monotech/NuXTv2/Project NuXT.sch

## KiCad design Project NuXT.sch (2020-03-05)

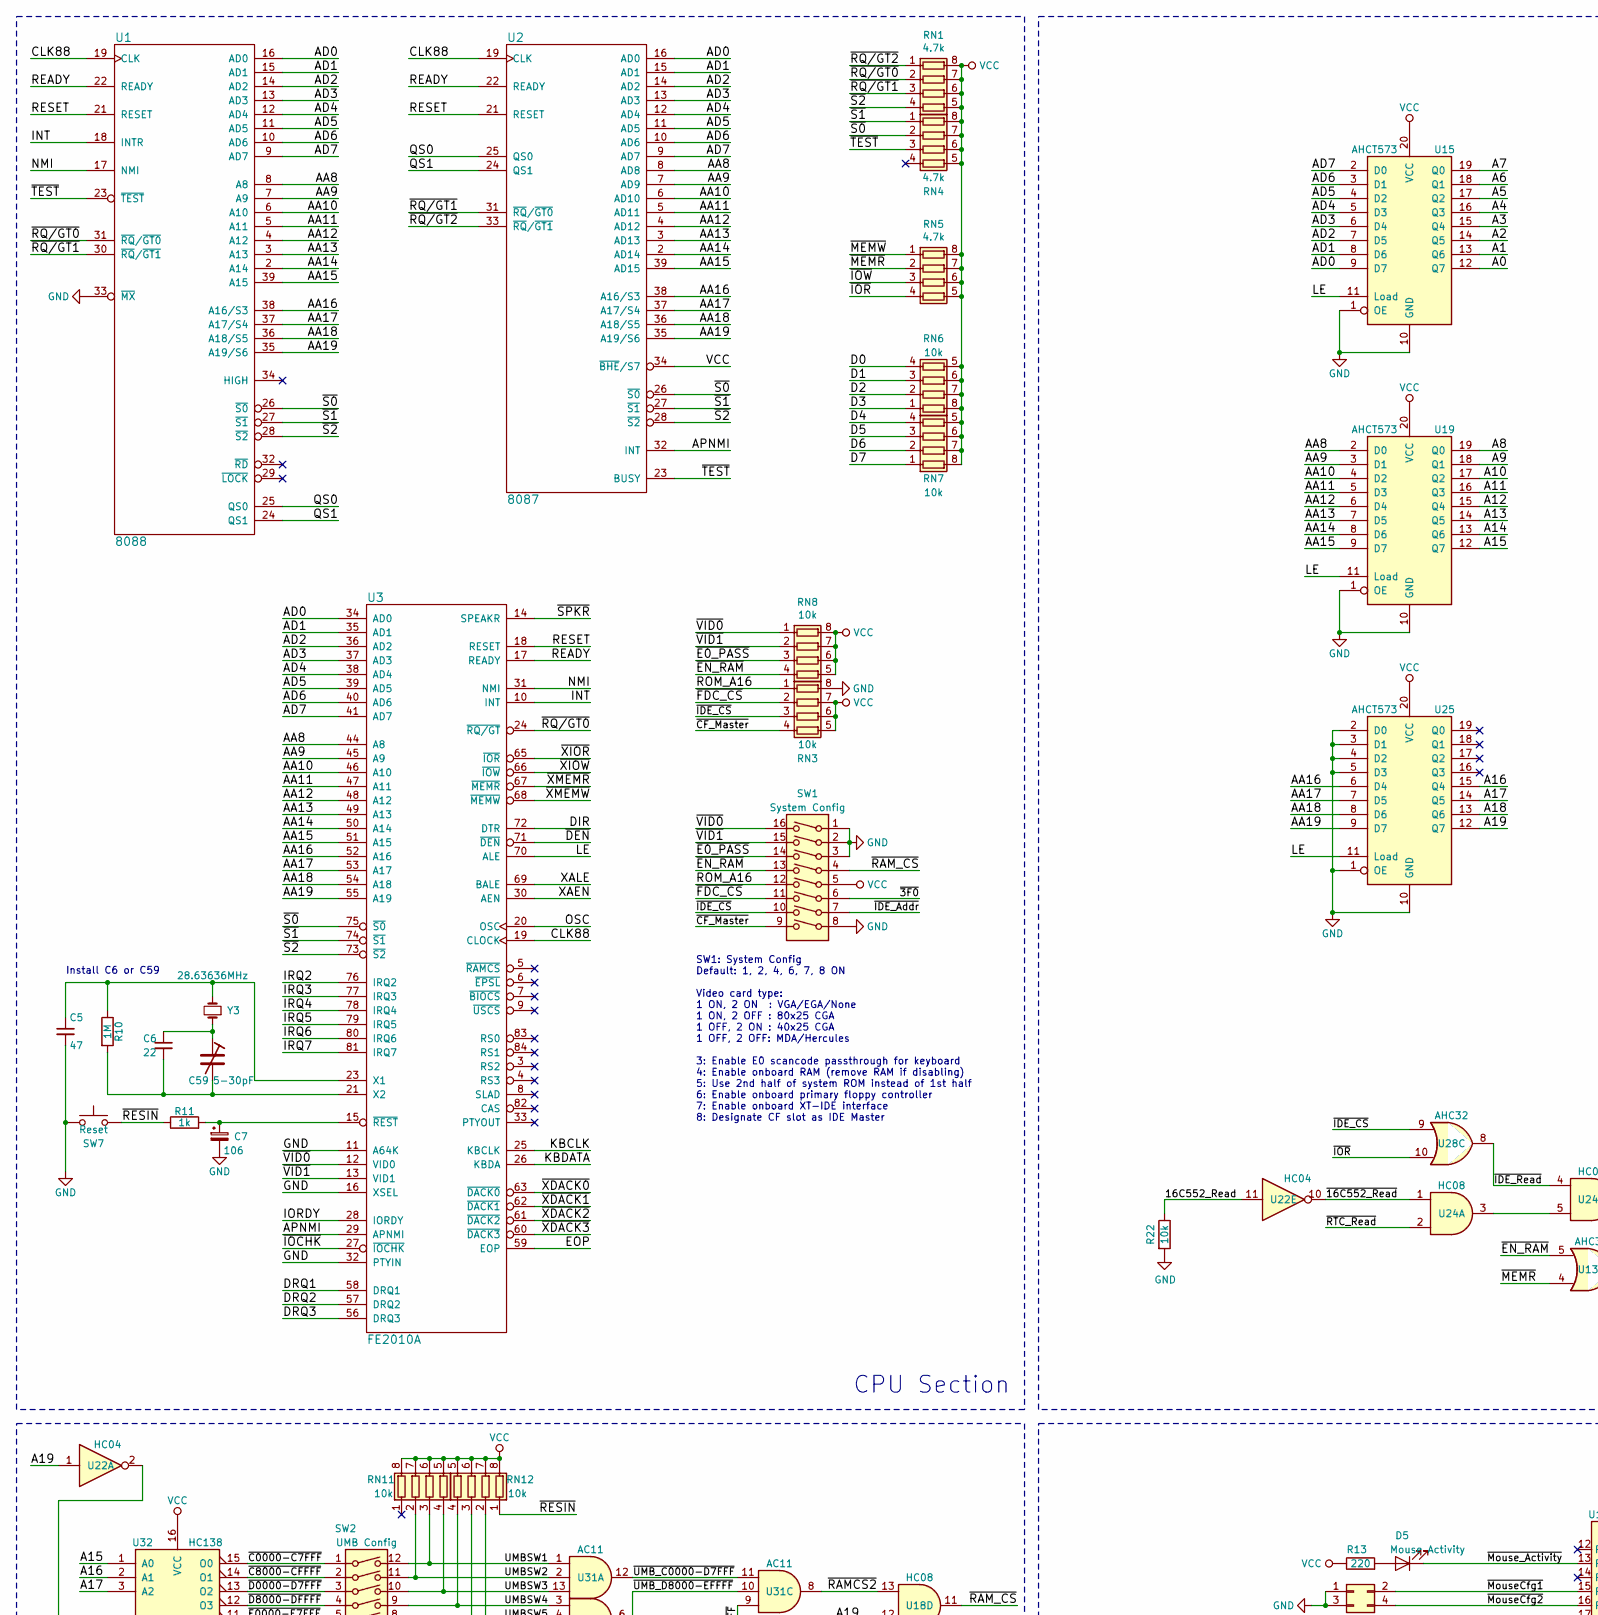
[picture p6: schematic Project NuXT.sch, part in row 1, column 1]

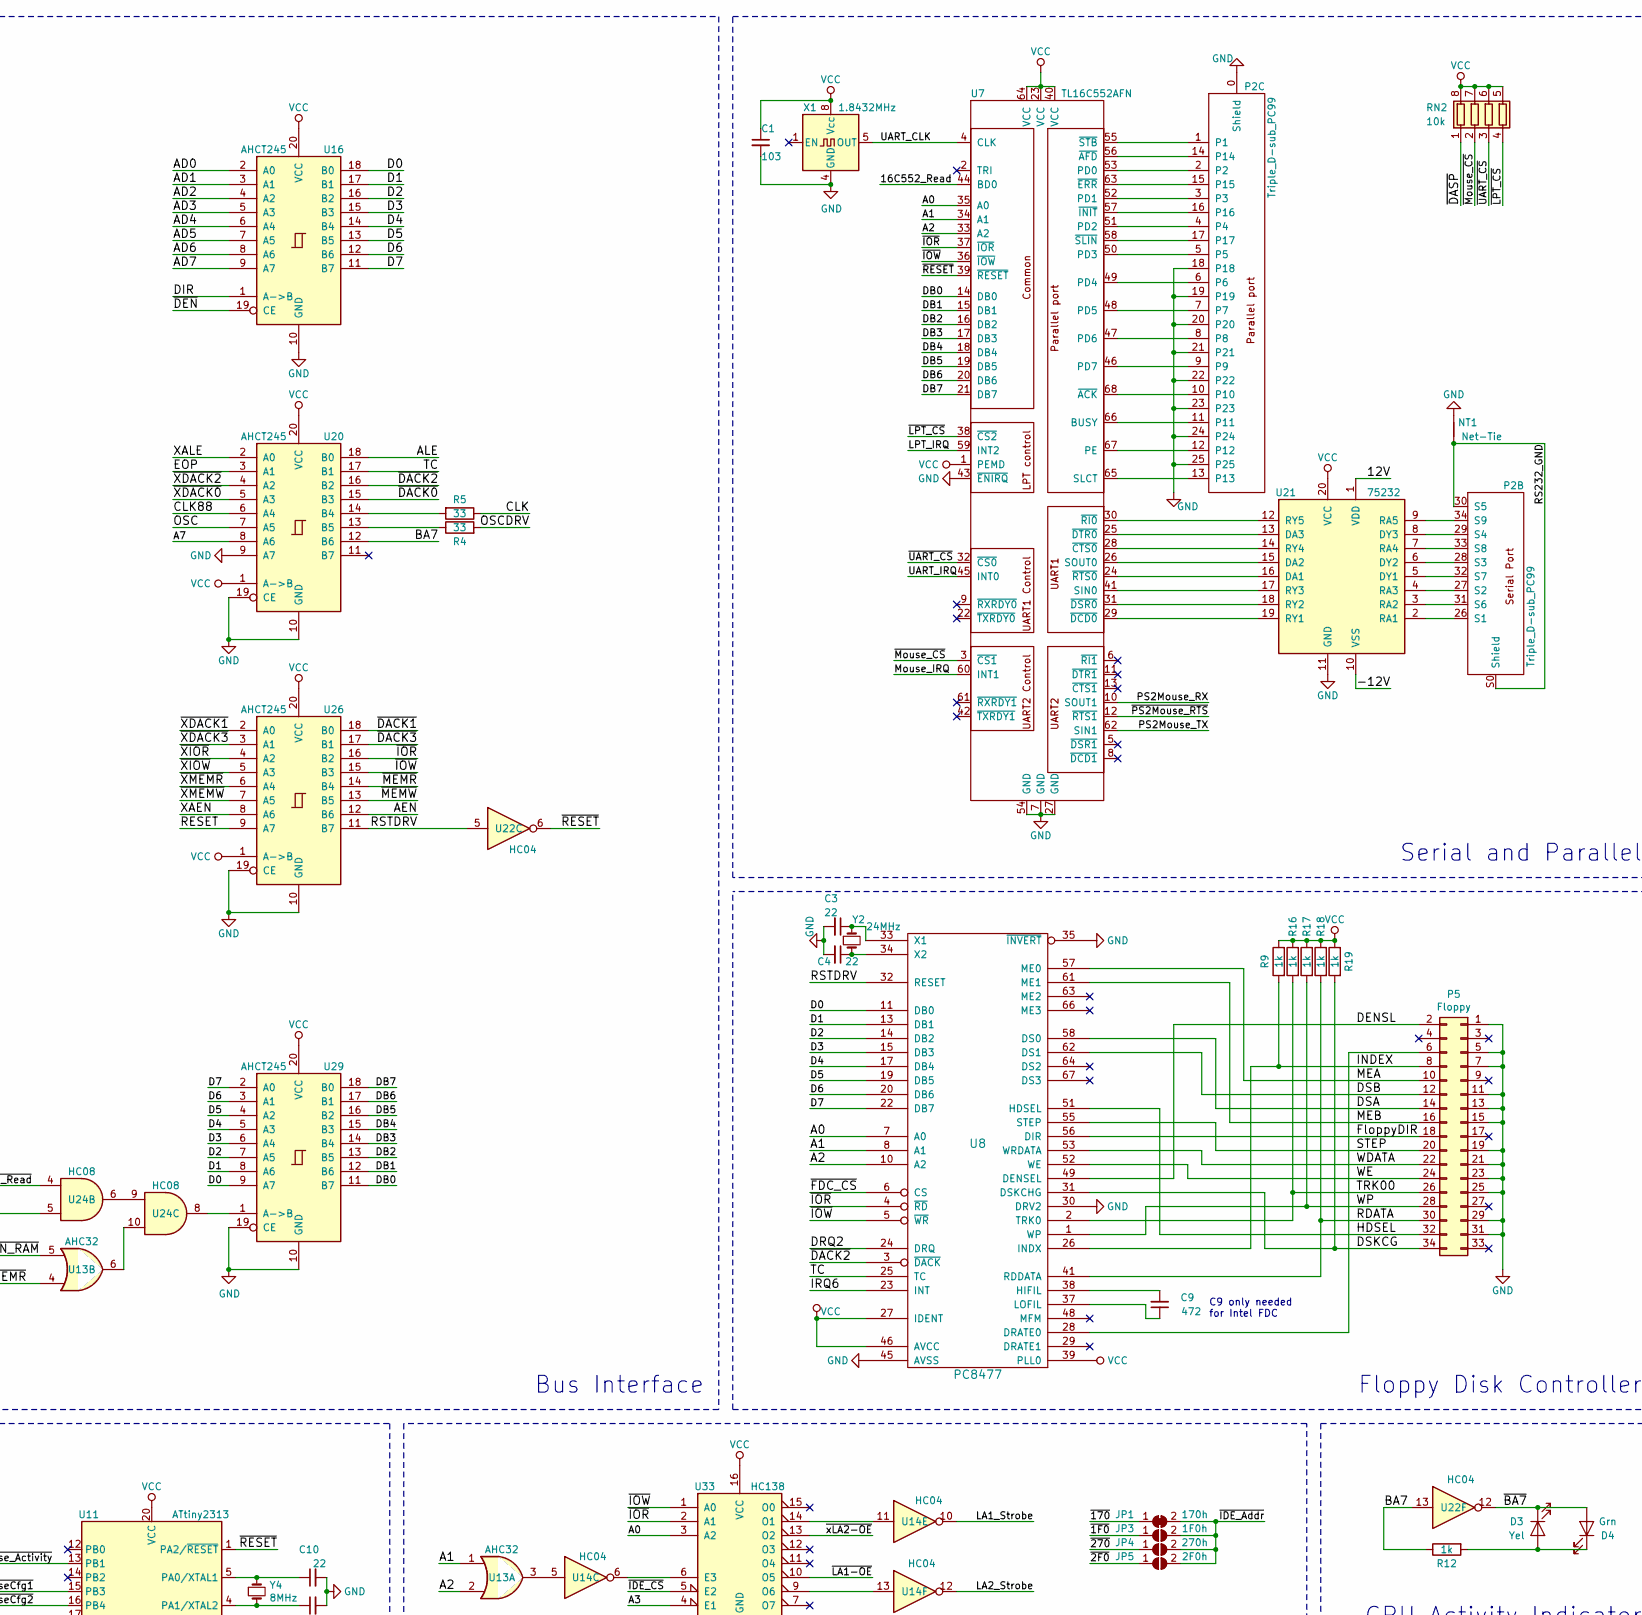
[picture p7: schematic Project NuXT.sch, part in row 1, column 2]

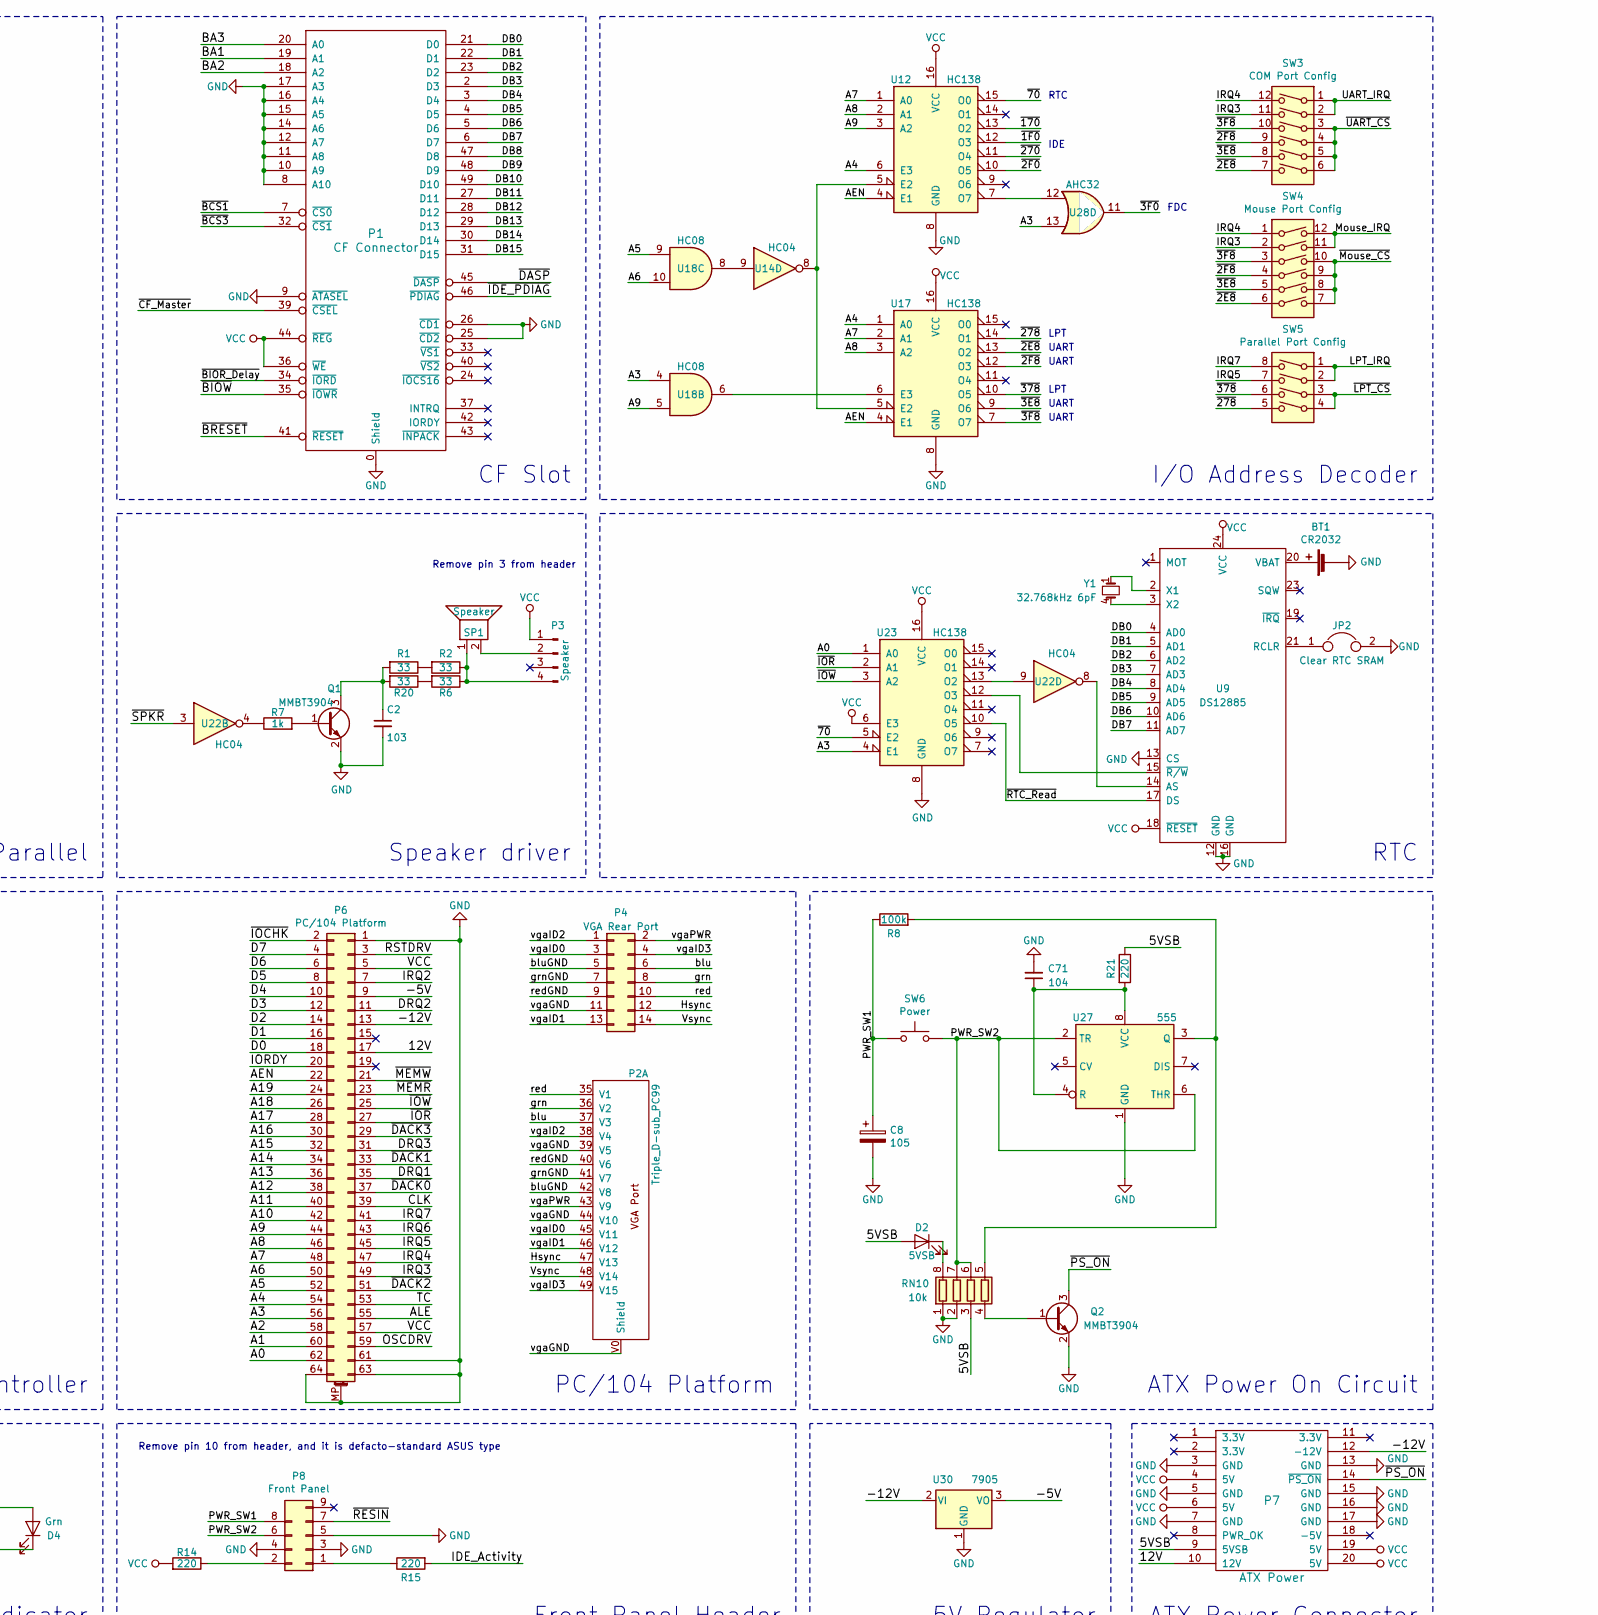
[picture p8: schematic Project NuXT.sch, part in row 1, column 3]

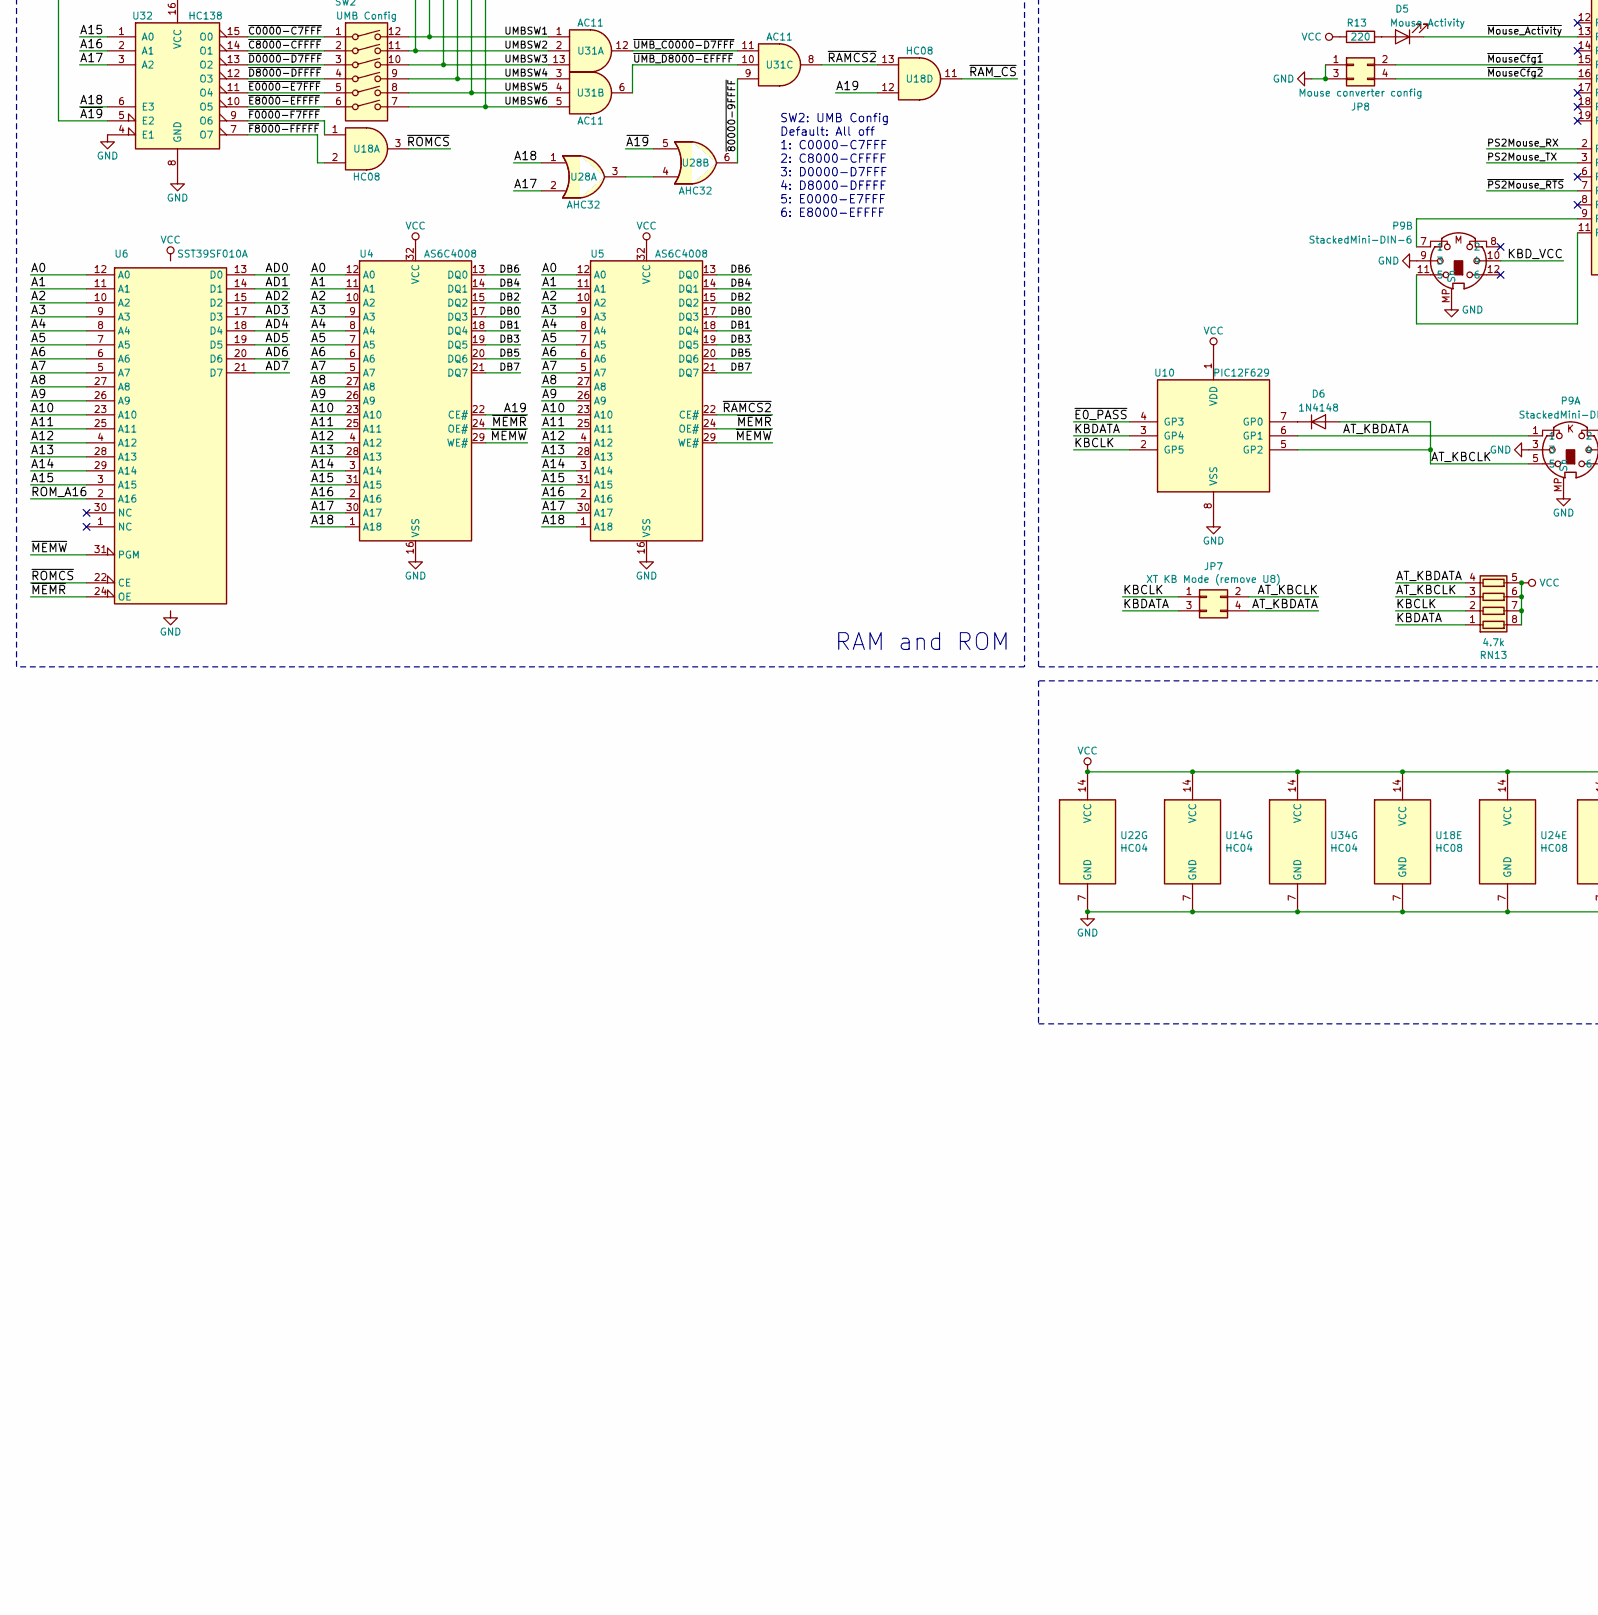
[picture p9: schematic Project NuXT.sch, part in row 2, column 1]

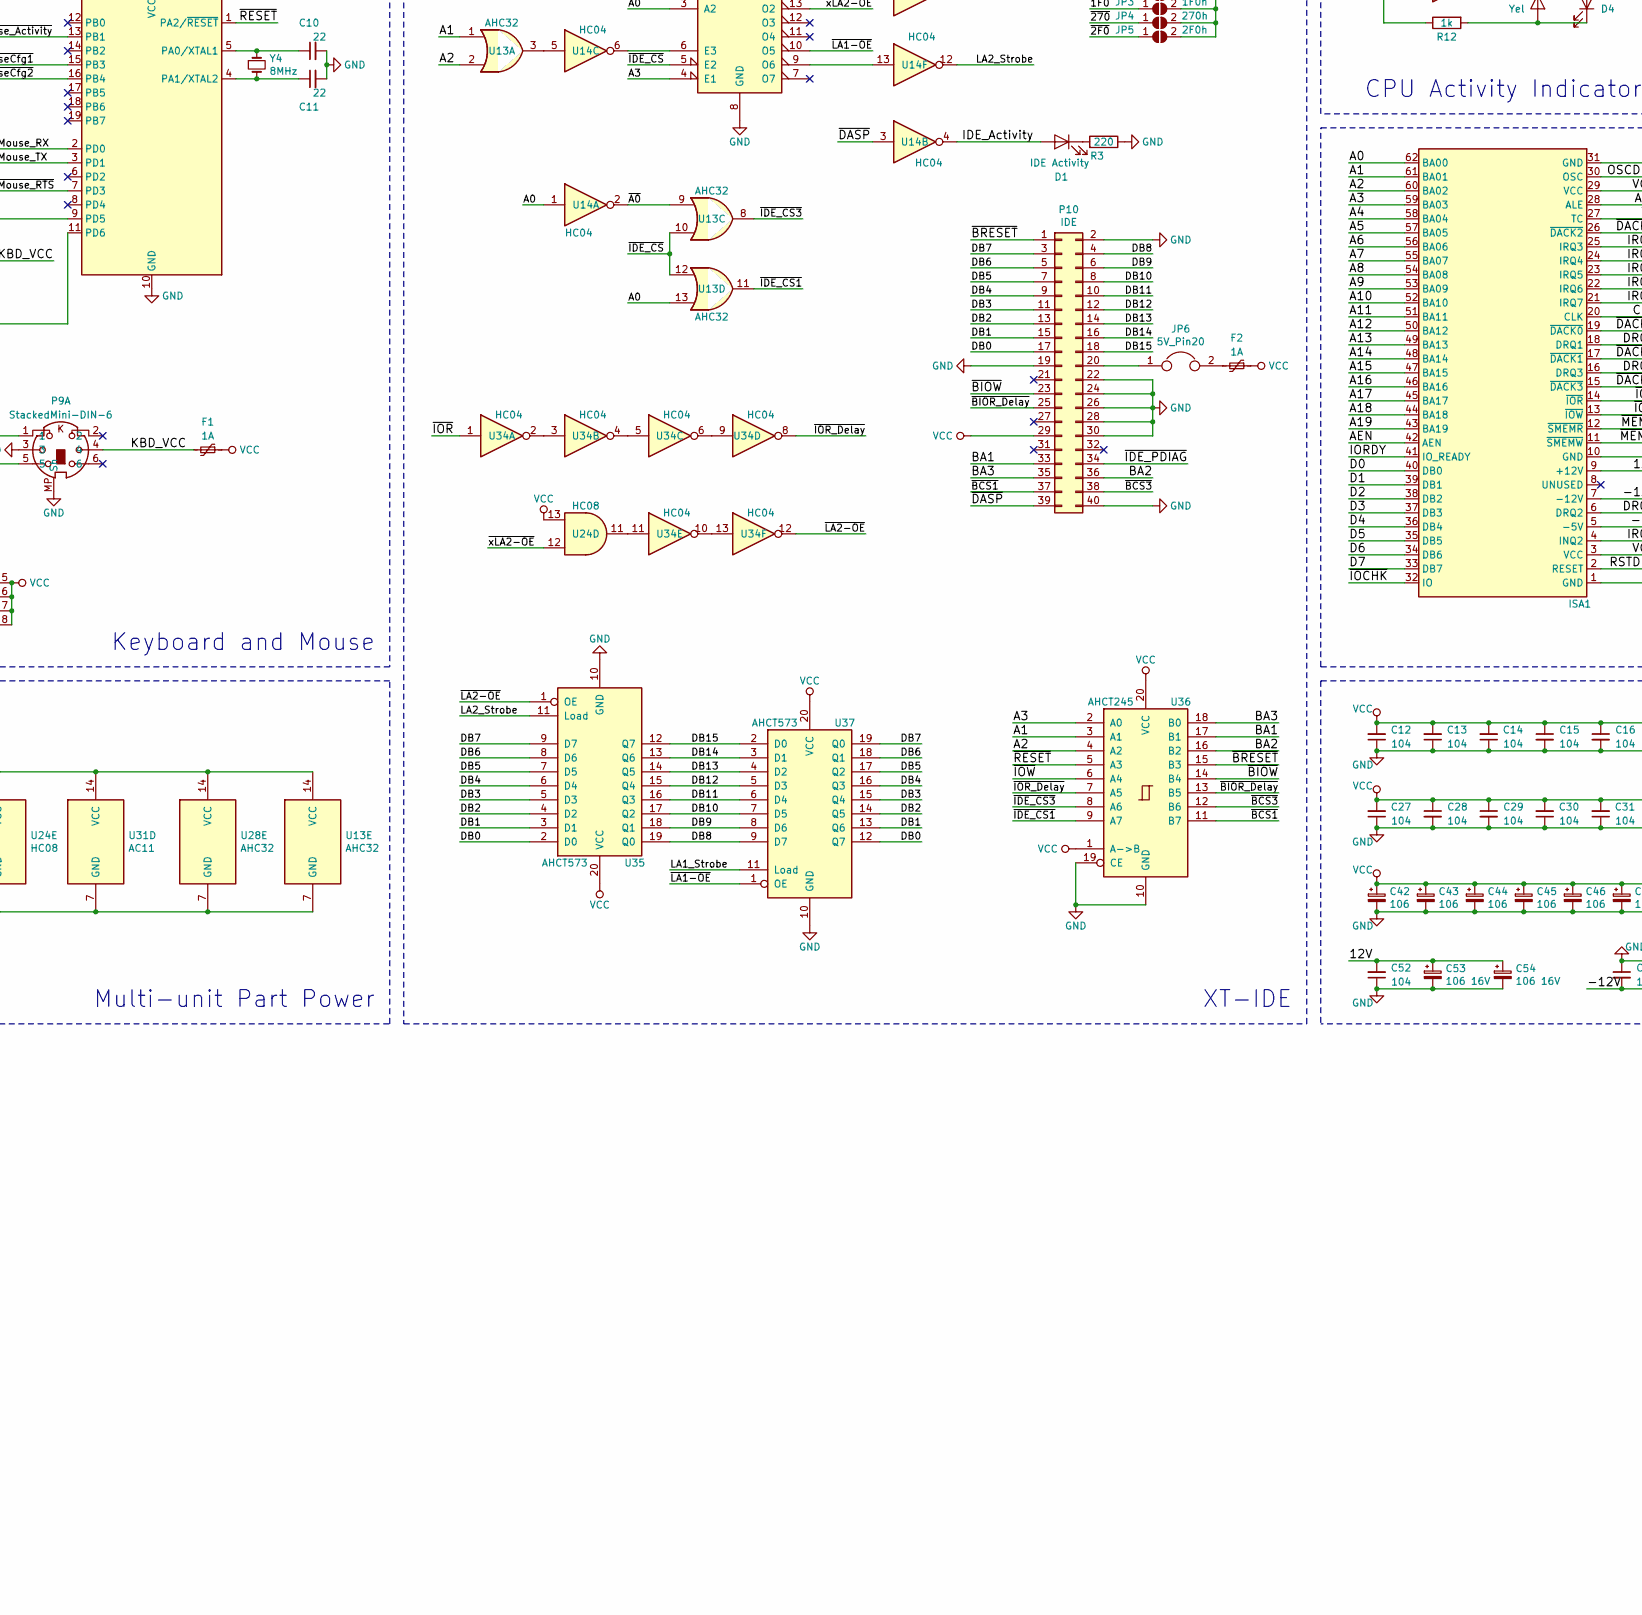
[picture p10: schematic Project NuXT.sch, part in row 2, column 2]

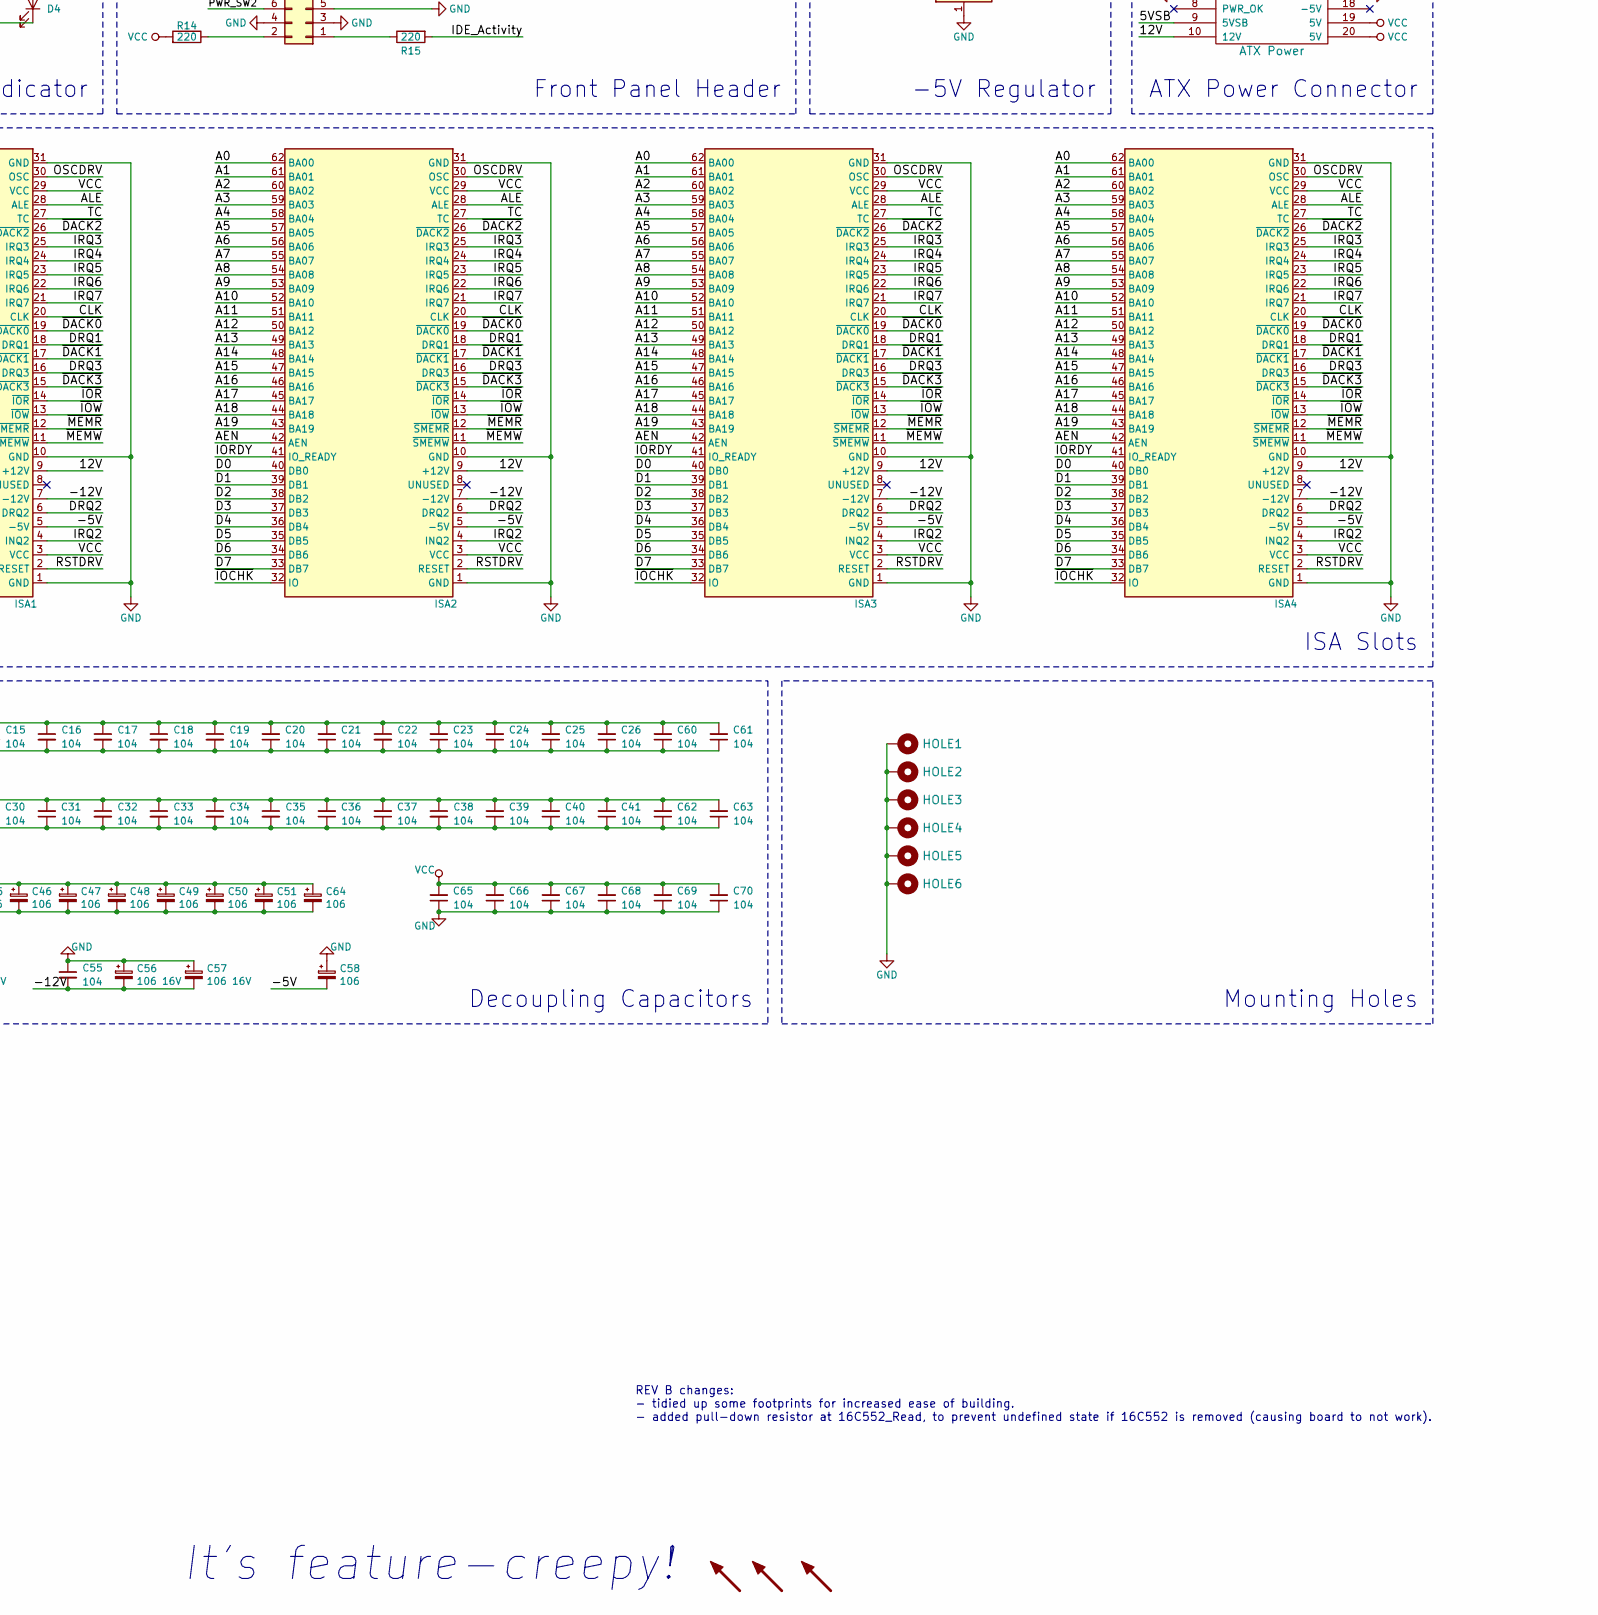
[picture p11: schematic Project NuXT.sch, part in row 2, column 3]

Parts:
BT1: CR2032; CR2032 THT Holder
C1, C2: 103; C_0805_2012Metric
C3, C4, C6, C10, C11: 22; C_0805_2012Metric
C5: 47; C_0805_2012Metric
C7, C42, C43, C44, C45, C46, C47, C48, C49, C50, C51, C58, C64: 106; C_0603_1608Metric
C8: 105; C_0805_2012Metric
C9: 472; C_0805_2012Metric
C12, C13, C14, C15, C16, C17, C18, C19, C20, C21, C22, C23, C24, C25, C26, C27, C28, C29, C30, C31, C32, C33, C34, C35, C36, C37, C38, C39, C40, C41, C52, C55, C60, C61, C62, C63, C65, C66, C67, C68, C69, C70, C71: 104; C_0603_1608Metric
C53, C54, C56, C57: 106 16V; C_0805_2012Metric
C59: 5-30pF; C_Trim_Murata
D1: IDE Activity; 3mm_LED_RightAngle
D2: 5VSB; LED_0805_2012Metric
D3: Yel; LED_0603_1608Metric
D4: Grn; LED_0603_1608Metric
D5: Mouse Activity; 3mm_LED_RightAngle
D6: 1N4148; D_SOD-123
F1, F2: 1A; Fuse_1812_4532Metric
HOLE1, HOLE2, HOLE3, HOLE4, HOLE5, HOLE6: HOLE; MountingHole_4mm_Pad_Via
ISA1, ISA2, ISA3, ISA4: Bus_ISA_8bit; Conn_Edge_ISA8_Longpads
JP1: 170h; SolderJumper-2_P1.3mm_Bridged_RoundedPad1.0x1.5mm
JP2: Clear RTC SRAM; SolderJumper-2_P1.3mm_Open_RoundedPad1.0x1.5mm
JP3: 1F0h; SolderJumper-2_P1.3mm_Open_RoundedPad1.0x1.5mm
JP4: 270h; SolderJumper-2_P1.3mm_Open_RoundedPad1.0x1.5mm
JP5: 2F0h; SolderJumper-2_P1.3mm_Open_RoundedPad1.0x1.5mm
JP6: 5V_Pin20; PinHeader_1x02_P2.54mm_Vertical
JP7: XT KB Mode (remove U8); PinHeader_2x02_P2.54mm_Vertical
JP8: Mouse converter config; PinHeader_2x02_P2.54mm_Vertical
LOGO1: SYM_Arrow45_Large; NuXT_2.0_Logo
LOGO2: SYM_Arrow45_Large; Monotech Logo Half 20x40mm
LOGO3: SYM_Arrow45_Large; Monotech Logo Half Flipped 20x40mm
NT1: Net-Tie; NetTie-2_SMD_Pad0.5mm
P1: CF Connector; CF_Slot_3M_N7E50-7516TS0884
P2: Triple_D-sub_PC99; Dsub_Triple_Stacked_DE9_DE15_DB25
P3: Speaker; PinHeader_1x04_3Loaded_P2.54mm_Horizontal
P4: VGA Rear Port; PinSocket_2x07_P2.54mm_Vertical
P5: Floppy; IDC-Header_2x17_P2.54mm_Vertical
P6: PC/104 Platform; PC104_Platform
P7: ATX Power; Molex_Mini-Fit_Jr_5569-20A2_2x10_P4.20mm_Horizontal
P8: Front Panel; PinHeader_2x05_P2.54mm_Horizontal
P9: StackedMini-DIN-6; Conn_Mini_DIN_6pin_Dual_Stacked
P10: IDE; IDC-Header_2x20_P2.54mm_Vertical
Q1, Q2: MMBT3904; SOT-23
R1, R2, R4, R5, R6, R20: 33; R_0805_2012Metric
R3, R13, R14, R15, R21: 220; R_0805_2012Metric
R7, R9, R11, R12, R16, R17, R18, R19: 1k; R_0805_2012Metric
R8: 100k; R_0805_2012Metric
R10: 1M; R_0805_2012Metric
R22: 10k; R_0805_2012Metric
RN1, RN4, RN5, RN13: 4.7k; R_Array_Convex_4x0603
RN2, RN3, RN6, RN7, RN8, RN10, RN11, RN12: 10k; R_Array_Convex_4x0603
SP1: Speaker; Buzzer_16x14RM7.6
SW1: System Config; SW_DIP_SPSTx08_Slide_9.78x22.5mm_W7.62mm_P2.54mm
SW2: UMB Config; SW_DIP_SPSTx06_Slide_9.78x17.42mm_W7.62mm_P2.54mm
SW3: COM Port Config; SW_DIP_SPSTx06_Slide_9.78x17.42mm_W7.62mm_P2.54mm
SW4: Mouse Port Config; SW_DIP_SPSTx06_Slide_9.78x17.42mm_W7.62mm_P2.54mm
SW5: Parallel Port Config; SW_DIP_SPSTx04_Slide_9.78x12.34mm_W7.62mm_P2.54mm
SW6: Power; SW_PUSH_6mm
SW7: Reset; SW_PUSH_6mm
U1: 8088; DIP-40_W15.24mm_Socket
U2: 8087; DIP-40_W15.24mm_Socket
U3: FE2010A; PLCC-84_THT-Socket
U4, U5: AS6C4008; DIP-32_W15.24mm_Socket
U6: SST39SF010A; DIP-32_W15.24mm_Socket
U7: TL16C552AFN; PLCC-68_THT-Socket
U8: PC8477; PLCC-68_THT-Socket
U9: DS12885; DIP-24_W15.24mm_Socket
U10: PIC12F629; DIP-8_W7.62mm_Socket
U11: ATtiny2313; DIP-20_W7.62mm_Socket
U12, U17, U23, U32, U33: HC138; SOIC-16_3.9x9.9mm_P1.27mm
U13, U28: AHC32; SOIC-14_3.9x8.7mm_P1.27mm
U14, U22, U34: HC04; SOIC-14_3.9x8.7mm_P1.27mm
U15, U19, U25, U35, U37: AHCT573; TSSOP-20_4.4x6.5mm_P0.65mm
U16, U20, U26, U29, U36: AHCT245; TSSOP-20_4.4x6.5mm_P0.65mm
U18, U24: HC08; SOIC-14_3.9x8.7mm_P1.27mm
U21: 75232; TSSOP-20_4.4x6.5mm_P0.65mm
U27: 555; SOIC-8_3.9x4.9mm_P1.27mm
U30: 7905; TO-252-2
U31: AC11; SOIC-14_3.9x8.7mm_P1.27mm
X1: 1.8432MHz; Oscillator_DIP-8
Y1: 32.768kHz 6pF; Crystal_SMD_Abracon_ABS25-4Pin_8.0x3.8mm
Y2: 24MHz; Crystal_SMD_5032-2Pin_5.0x3.2mm
Y3: 28.63636MHz; Crystal_SMD_5032-2Pin_5.0x3.2mm
Y4: 8MHz; Crystal_SMD_5032-2Pin_5.0x3.2mm

Connections:
5VSB: D2.2 (A), P7.9 (5VSB), R21.1, RN10.3 (R3.1)
12V: C52.2, C53.1, C54.1, ISA1.9 (+12V), ISA2.9 (+12V), ISA3.9 (+12V), ISA4.9 (+12V), P6.17, P7.10 (12V), U21.1 (VDD)
16C552_Read: R22.1, U7.44 (BD0), U22.11
-5V: C58.2, ISA1.5 (-5V), ISA2.5 (-5V), ISA3.5 (-5V), ISA4.5 (-5V), P6.9, U30.3 (VO)
-12V: C55.2, C56.2, C57.2, ISA1.7 (-12V), ISA2.7 (-12V), ISA3.7 (-12V), ISA4.7 (-12V), P6.13, P7.12 (-12V), U21.10 (VSS), U30.2 (VI)
A0: ISA1.62 (BA00), ISA2.62 (BA00), ISA3.62 (BA00), ISA4.62 (BA00), P6.62, U4.12 (A0), U5.12 (A0), U6.12 (A0), U7.35 (A0), U8.7 (A0), U13.13, U14.1, U15.12 (Q7), U23.1 (A0), U33.3 (A2)
A1: ISA1.61 (BA01), ISA2.61 (BA01), ISA3.61 (BA01), ISA4.61 (BA01), P6.60, U4.11 (A1), U5.11 (A1), U6.11 (A1), U7.34 (A1), U8.8 (A1), U13.1, U15.13 (Q6), U36.3 (A1)
A2: ISA1.60 (BA02), ISA2.60 (BA02), ISA3.60 (BA02), ISA4.60 (BA02), P6.58, U4.10 (A2), U5.10 (A2), U6.10 (A2), U7.33 (A2), U8.10 (A2), U13.2, U15.14 (Q5), U36.4 (A2)
A3: ISA1.59 (BA03), ISA2.59 (BA03), ISA3.59 (BA03), ISA4.59 (BA03), P6.56, U4.9 (A3), U5.9 (A3), U6.9 (A3), U15.15 (Q4), U18.4, U23.4 (E1), U28.13, U33.4 (E1), U36.2 (A0)
A4: ISA1.58 (BA04), ISA2.58 (BA04), ISA3.58 (BA04), ISA4.58 (BA04), P6.54, U4.8 (A4), U5.8 (A4), U6.8 (A4), U12.6 (E3), U15.16 (Q3), U17.1 (A0)
A5: ISA1.57 (BA05), ISA2.57 (BA05), ISA3.57 (BA05), ISA4.57 (BA05), P6.52, U4.7 (A5), U5.7 (A5), U6.7 (A5), U15.17 (Q2), U18.9
A6: ISA1.56 (BA06), ISA2.56 (BA06), ISA3.56 (BA06), ISA4.56 (BA06), P6.50, U4.6 (A6), U5.6 (A6), U6.6 (A6), U15.18 (Q1), U18.10
A7: ISA1.55 (BA07), ISA2.55 (BA07), ISA3.55 (BA07), ISA4.55 (BA07), P6.48, U4.5 (A7), U5.5 (A7), U6.5 (A7), U12.1 (A0), U15.19 (Q0), U17.2 (A1), U20.8 (A6)
A8: ISA1.54 (BA08), ISA2.54 (BA08), ISA3.54 (BA08), ISA4.54 (BA08), P6.46, U4.27 (A8), U5.27 (A8), U6.27 (A8), U12.2 (A1), U17.3 (A2), U19.19 (Q0)
A9: ISA1.53 (BA09), ISA2.53 (BA09), ISA3.53 (BA09), ISA4.53 (BA09), P6.44, U4.26 (A9), U5.26 (A9), U6.26 (A9), U12.3 (A2), U18.5, U19.18 (Q1)
A10: ISA1.52 (BA10), ISA2.52 (BA10), ISA3.52 (BA10), ISA4.52 (BA10), P6.42, U4.23 (A10), U5.23 (A10), U6.23 (A10), U19.17 (Q2)
A11: ISA1.51 (BA11), ISA2.51 (BA11), ISA3.51 (BA11), ISA4.51 (BA11), P6.40, U4.25 (A11), U5.25 (A11), U6.25 (A11), U19.16 (Q3)
A12: ISA1.50 (BA12), ISA2.50 (BA12), ISA3.50 (BA12), ISA4.50 (BA12), P6.38, U4.4 (A12), U5.4 (A12), U6.4 (A12), U19.15 (Q4)
A13: ISA1.49 (BA13), ISA2.49 (BA13), ISA3.49 (BA13), ISA4.49 (BA13), P6.36, U4.28 (A13), U5.28 (A13), U6.28 (A13), U19.14 (Q5)
A14: ISA1.48 (BA14), ISA2.48 (BA14), ISA3.48 (BA14), ISA4.48 (BA14), P6.34, U4.3 (A14), U5.3 (A14), U6.29 (A14), U19.13 (Q6)
A15: ISA1.47 (BA15), ISA2.47 (BA15), ISA3.47 (BA15), ISA4.47 (BA15), P6.32, U4.31 (A15), U5.31 (A15), U6.3 (A15), U19.12 (Q7), U32.1 (A0)
A16: ISA1.46 (BA16), ISA2.46 (BA16), ISA3.46 (BA16), ISA4.46 (BA16), P6.30, U4.2 (A16), U5.2 (A16), U25.15 (Q4), U32.2 (A1)
A17: ISA1.45 (BA17), ISA2.45 (BA17), ISA3.45 (BA17), ISA4.45 (BA17), P6.28, U4.30 (A17), U5.30 (A17), U25.14 (Q5), U28.2, U32.3 (A2)
A18: ISA1.44 (BA18), ISA2.44 (BA18), ISA3.44 (BA18), ISA4.44 (BA18), P6.26, U4.1 (A18), U5.1 (A18), U25.13 (Q6), U28.1, U32.6 (E3)
A19: ISA1.43 (BA19), ISA2.43 (BA19), ISA3.43 (BA19), ISA4.43 (BA19), P6.24, U4.22 (CE#), U18.12, U22.1, U25.12 (Q7)
AA8: U1.8 (A8), U2.8 (AD8), U3.44 (A8), U19.2 (D0)
AA9: U1.7 (A9), U2.7 (AD9), U3.45 (A9), U19.3 (D1)
AA10: U1.6 (A10), U2.6 (AD10), U3.46 (A10), U19.4 (D2)
AA11: U1.5 (A11), U2.5 (AD11), U3.47 (A11), U19.5 (D3)
AA12: U1.4 (A12), U2.4 (AD12), U3.48 (A12), U19.6 (D4)
AA13: U1.3 (A13), U2.3 (AD13), U3.49 (A13), U19.7 (D5)
AA14: U1.2 (A14), U2.2 (AD14), U3.50 (A14), U19.8 (D6)
AA15: U1.39 (A15), U2.39 (AD15), U3.51 (A15), U19.9 (D7)
AA16: U1.38 (A16/S3), U2.38 (A16/S3), U3.52 (A16), U25.6 (D4)
AA17: U1.37 (A17/S4), U2.37 (A17/S4), U3.53 (A17), U25.7 (D5)
AA18: U1.36 (A18/S5), U2.36 (A18/S5), U3.54 (A18), U25.8 (D6)
AA19: U1.35 (A19/S6), U2.35 (A19/S6), U3.55 (A19), U25.9 (D7)
AD0: U1.16 (AD0), U2.16 (AD0), U3.34 (AD0), U6.13 (D0), U15.9 (D7), U16.2 (A0)
AD1: U1.15 (AD1), U2.15 (AD1), U3.35 (AD1), U6.14 (D1), U15.8 (D6), U16.3 (A1)
AD2: U1.14 (AD2), U2.14 (AD2), U3.36 (AD2), U6.15 (D2), U15.7 (D5), U16.4 (A2)
AD3: U1.13 (AD3), U2.13 (AD3), U3.37 (AD3), U6.17 (D3), U15.6 (D4), U16.5 (A3)
AD4: U1.12 (AD4), U2.12 (AD4), U3.38 (AD4), U6.18 (D4), U15.5 (D3), U16.6 (A4)
AD5: U1.11 (AD5), U2.11 (AD5), U3.39 (AD5), U6.19 (D5), U15.4 (D2), U16.7 (A5)
AD6: U1.10 (AD6), U2.10 (AD6), U3.40 (AD6), U6.20 (D6), U15.3 (D1), U16.8 (A6)
AD7: U1.9 (AD7), U2.9 (AD7), U3.41 (AD7), U6.21 (D7), U15.2 (D0), U16.9 (A7)
AEN: ISA1.42 (AEN), ISA2.42 (AEN), ISA3.42 (AEN), ISA4.42 (AEN), P6.22, U12.4 (E1), U17.4 (E1), U26.12 (B6)
ALE: ISA1.28 (ALE), ISA2.28 (ALE), ISA3.28 (ALE), ISA4.28 (ALE), P6.55, U20.18 (B0)
APNMI: U2.32 (INT), U3.29 (APNMI)
AT_KBCLK: D6.2 (A), JP7.2, P9.5, RN13.3 (R3.1), U10.5 (GP2)
AT_KBDATA: JP7.4, P9.1, RN13.4 (R4.1), U10.6 (GP1)
BA1: P1.19 (A1), P10.33, U36.17 (B1)
BA2: P1.18 (A2), P10.36, U36.16 (B2)
BA3: P1.20 (A0), P10.35, U36.18 (B0)
BA7: R12.1, U20.12 (B6), U22.13
CLK: ISA1.20 (CLK), ISA2.20 (CLK), ISA3.20 (CLK), ISA4.20 (CLK), P6.39, R5.1
CLK88: U1.19 (CLK), U2.19 (CLK), U3.19 (CLOCK), U20.6 (A4)
D0: ISA1.40 (DB0), ISA2.40 (DB0), ISA3.40 (DB0), ISA4.40 (DB0), P6.18, RN6.4 (R4.1), U8.11 (DB0), U16.18 (B0), U29.9 (A7)
D1: ISA1.39 (DB1), ISA2.39 (DB1), ISA3.39 (DB1), ISA4.39 (DB1), P6.16, RN6.3 (R3.1), U8.13 (DB1), U16.17 (B1), U29.8 (A6)
D2: ISA1.38 (DB2), ISA2.38 (DB2), ISA3.38 (DB2), ISA4.38 (DB2), P6.14, RN6.2 (R2.1), U8.14 (DB2), U16.16 (B2), U29.7 (A5)
D3: ISA1.37 (DB3), ISA2.37 (DB3), ISA3.37 (DB3), ISA4.37 (DB3), P6.12, RN6.1 (R1.1), U8.15 (DB3), U16.15 (B3), U29.6 (A4)
D4: ISA1.36 (DB4), ISA2.36 (DB4), ISA3.36 (DB4), ISA4.36 (DB4), P6.10, RN7.4 (R4.1), U8.17 (DB4), U16.14 (B4), U29.5 (A3)
D5: ISA1.35 (DB5), ISA2.35 (DB5), ISA3.35 (DB5), ISA4.35 (DB5), P6.8, RN7.3 (R3.1), U8.19 (DB5), U16.13 (B5), U29.4 (A2)
D6: ISA1.34 (DB6), ISA2.34 (DB6), ISA3.34 (DB6), ISA4.34 (DB6), P6.6, RN7.2 (R2.1), U8.20 (DB6), U16.12 (B6), U29.3 (A1)
D7: ISA1.33 (DB7), ISA2.33 (DB7), ISA3.33 (DB7), ISA4.33 (DB7), P6.4, RN7.1 (R1.1), U8.22 (DB7), U16.11 (B7), U29.2 (A0)
DB0: P1.21 (D0), P10.17, U4.17 (DQ3), U5.17 (DQ3), U7.14 (DB0), U9.4 (AD0), U29.11 (B7), U35.2 (D0), U37.12 (Q7)
DB1: P1.22 (D1), P10.15, U4.18 (DQ4), U5.18 (DQ4), U7.15 (DB1), U9.5 (AD1), U29.12 (B6), U35.3 (D1), U37.13 (Q6)
DB2: P1.23 (D2), P10.13, U4.15 (DQ2), U5.15 (DQ2), U7.16 (DB2), U9.6 (AD2), U29.13 (B5), U35.4 (D2), U37.14 (Q5)
DB3: P1.2 (D3), P10.11, U4.19 (DQ5), U5.19 (DQ5), U7.17 (DB3), U9.7 (AD3), U29.14 (B4), U35.5 (D3), U37.15 (Q4)
DB4: P1.3 (D4), P10.9, U4.14 (DQ1), U5.14 (DQ1), U7.18 (DB4), U9.8 (AD4), U29.15 (B3), U35.6 (D4), U37.16 (Q3)
DB5: P1.4 (D5), P10.7, U4.20 (DQ6), U5.20 (DQ6), U7.19 (DB5), U9.9 (AD5), U29.16 (B2), U35.7 (D5), U37.17 (Q2)
DB6: P1.5 (D6), P10.5, U4.13 (DQ0), U5.13 (DQ0), U7.20 (DB6), U9.10 (AD6), U29.17 (B1), U35.8 (D6), U37.18 (Q1)
DB7: P1.6 (D7), P10.3, U4.21 (DQ7), U5.21 (DQ7), U7.21 (DB7), U9.11 (AD7), U29.18 (B0), U35.9 (D7), U37.19 (Q0)
DB8: P1.47 (D8), P10.4, U35.19 (Q0), U37.9 (D7)
DB9: P1.48 (D9), P10.6, U35.18 (Q1), U37.8 (D6)
DB10: P1.49 (D10), P10.8, U35.17 (Q2), U37.7 (D5)
DB11: P1.27 (D11), P10.10, U35.16 (Q3), U37.6 (D4)
DB12: P1.28 (D12), P10.12, U35.15 (Q4), U37.5 (D3)
DB13: P1.29 (D13), P10.14, U35.14 (Q5), U37.4 (D2)
DB14: P1.30 (D14), P10.16, U35.13 (Q6), U37.3 (D1)
DB15: P1.31 (D15), P10.18, U35.12 (Q7), U37.2 (D0)
DENSL: P5.2, U8.49 (DENSEL)
DIR: U3.72 (DTR), U16.1 (A->B)
DRQ1: ISA1.18 (DRQ1), ISA2.18 (DRQ1), ISA3.18 (DRQ1), ISA4.18 (DRQ1), P6.35, U3.58 (DRQ1)
DRQ2: ISA1.6 (DRQ2), ISA2.6 (DRQ2), ISA3.6 (DRQ2), ISA4.6 (DRQ2), P6.11, U3.57 (DRQ2), U8.24 (DRQ)
DRQ3: ISA1.16 (DRQ3), ISA2.16 (DRQ3), ISA3.16 (DRQ3), ISA4.16 (DRQ3), P6.31, U3.56 (DRQ3)
DSA: P5.14, U8.58 (DS0)
DSB: P5.12, U8.62 (DS1)
DSKCG: P5.34, R19.2, U8.31 (DSKCHG)
EOP: U3.59 (EOP), U20.3 (A1)
FloppyDIR: P5.18, U8.56 (DIR)
GND: BT1.2 (-), C1.2, C2.2, C3.2, C4.2, C5.2, C7.2, C8.2, C10.2, C11.2, C12.1, C13.1, C14.1, C15.2, C16.2, C17.2, C18.2, C19.2, C20.1, C21.1, C22.2, C23.1, C24.1, C25.1, C26.1, C27.1, C28.2, C29.2, C30.1, C31.1, C32.2, C33.2, C34.2, C35.2, C36.1, C37.1, C38.2, C39.1, C40.1, C41.1, C42.2, C43.2, C44.2, C45.2, C46.2, C47.2, C48.2, C49.2, C50.2, C51.2, C52.1, C53.2, C54.2, C55.1, C56.1, C57.1, C58.1, C60.1, C61.1, C62.1, C63.1, C64.2, C65.1, C66.1, C67.1, C68.1, C69.1, C70.1, C71.2, HOLE1.1, HOLE2.1, HOLE3.1, HOLE4.1, HOLE5.1, HOLE6.1, ISA1.1 (GND), ISA1.10 (GND), ISA1.31 (GND), ISA2.1 (GND), ISA2.10 (GND), ISA2.31 (GND), ISA3.1 (GND), ISA3.10 (GND), ISA3.31 (GND), ISA4.1 (GND), ISA4.10 (GND), ISA4.31 (GND), JP2.2, JP8.1, JP8.3, NT1.2, P1.0 (Shield), P1.8 (A10), P1.9 (~ATASEL), P1.10 (A9), P1.11 (A8), P1.12 (A7), P1.14 (A6), P1.15 (A5), P1.16 (A4), P1.17 (A3), P1.25 (~CD2), P1.26 (~CD1), P2.0 (Shield), P2.18, P2.19, P2.20, P2.21, P2.22, P2.23, P2.24, P2.25, P5.1, P5.5, P5.7, P5.11, P5.13, P5.15, P5.19, P5.21, P5.23, P5.25, P5.29, P5.31, P6.1, P6.61, P6.63, P6.64, P6.MP (MountPin), P7.3 (GND), P7.5 (GND), P7.7 (GND), P7.13 (GND), P7.15 (GND), P7.16 (GND), P7.17 (GND), P8.3, P8.4, P8.5, P9.3, P9.9 (3), P9.MP (Sh), P10.2, P10.19, P10.22, P10.24, P10.26, P10.28, P10.30, P10.40, Q1.2 (E), Q2.2 (E), R3.1, R22.2, RN3.8 (R1.2), RN10.1 (R1.1), RN10.2 (R2.1), SW1.1, SW1.2, SW1.3, SW1.8, SW7.1, U1.33 (~MX), U3.11 (A64K), U3.16 (XSEL), U3.32 (PTYIN), U4.16 (VSS), U5.16 (VSS), U6.16 (GND), U7.7 (GND), U7.27 (GND), U7.43 (~ENIRQ), U7.54 (GND), U8.30 (DRV2), U8.35 (~INVERT), U8.45 (AVSS), U9.12 (GND), U9.13 (CS), U9.16 (GND), U10.8 (VSS), U11.10 (GND), U12.8 (GND), U13.7 (GND), U14.7 (GND), U15.1 (OE), U15.10 (GND), U16.10 (GND), U17.8 (GND), U18.7 (GND), U19.1 (OE), U19.10 (GND), U20.9 (A7), U20.10 (GND), U20.19 (CE), U21.11 (GND), U22.7 (GND), U23.8 (GND), U24.7 (GND), U25.1 (OE), U25.2 (D0), U25.3 (D1), U25.4 (D2), U25.5 (D3), U25.10 (GND), U26.10 (GND), U26.19 (CE), U27.1 (GND), U28.7 (GND), U29.10 (GND), U29.19 (CE), U30.1 (GND), U31.7 (GND), U32.4 (E1), U32.8 (GND), U33.8 (GND), U34.7 (GND), U35.10 (GND), U36.10 (GND), U36.19 (CE), U37.10 (GND), X1.4 (GND)
HDSEL: P5.32, U8.51 (HDSEL)
Hsync: P2.47 (V13), P4.12
IDE_Activity: D1.2 (A), R15.2, U14.4
INDEX: P5.8, R9.2, U8.26 (INDX)
INT: U1.18 (INTR), U3.10 (INT)
IORDY: ISA1.41 (IO_READY), ISA2.41 (IO_READY), ISA3.41 (IO_READY), ISA4.41 (IO_READY), P6.20, U3.28 (IORDY)
IRQ2: ISA1.4 (INQ2), ISA2.4 (INQ2), ISA3.4 (INQ2), ISA4.4 (INQ2), P6.7, U3.76 (IRQ2)
IRQ3: ISA1.25 (IRQ3), ISA2.25 (IRQ3), ISA3.25 (IRQ3), ISA4.25 (IRQ3), P6.49, SW3.11, SW4.2, U3.77 (IRQ3)
IRQ4: ISA1.24 (IRQ4), ISA2.24 (IRQ4), ISA3.24 (IRQ4), ISA4.24 (IRQ4), P6.47, SW3.12, SW4.1, U3.78 (IRQ4)
IRQ5: ISA1.23 (IRQ5), ISA2.23 (IRQ5), ISA3.23 (IRQ5), ISA4.23 (IRQ5), P6.45, SW5.7, U3.79 (IRQ5)
IRQ6: ISA1.22 (IRQ6), ISA2.22 (IRQ6), ISA3.22 (IRQ6), ISA4.22 (IRQ6), P6.43, U3.80 (IRQ6), U8.23 (INT)
IRQ7: ISA1.21 (IRQ7), ISA2.21 (IRQ7), ISA3.21 (IRQ7), ISA4.21 (IRQ7), P6.41, SW5.8, U3.81 (IRQ7)
KBCLK: JP7.1, RN13.2 (R2.1), U3.25 (KBCLK), U10.2 (GP5)
KBDATA: JP7.3, RN13.1 (R1.1), U3.26 (KBDA), U10.3 (GP4)
KBD_VCC: F1.2, P9.4, P9.10 (4)
LA1_Strobe: U14.10, U37.11 (Load)
LA2_Strobe: U14.12, U35.11 (Load)
LE: U3.70 (ALE), U15.11 (Load), U19.11 (Load), U25.11 (Load)
LPT_IRQ: SW5.1, SW5.2, U7.59 (INT2)
MEA: P5.10, U8.57 (ME0)
MEB: P5.16, U8.61 (ME1)
Mouse_IRQ: SW4.11, SW4.12, U7.60 (INT1)
NMI: U1.17 (NMI), U3.31 (NMI)
unnamed: BT1.1 (+), U9.20 (VBAT)
unnamed: C2.1, Q1.3 (C), R1.2, R20.2
unnamed: C3.1, U8.33 (X1), Y2.1
unnamed: C4.1, U8.34 (X2), Y2.2
unnamed: C5.1, R10.1, U3.23 (X1), Y3.2
unnamed: C7.1, R11.2, U3.15 (~REST)
unnamed: C9.1, U8.37 (LOFIL)
unnamed: C9.2, U8.38 (HIFIL)
unnamed: C10.1, U11.5 (PA0/XTAL1), Y4.1
unnamed: C11.1, U11.4 (PA1/XTAL2), Y4.2
unnamed: C6.1, C59.1, Y3.1
unnamed: C6.2, C59.2, R10.2, U3.21 (X2)
unnamed: C71.1, R21.2, U27.4 (R), U27.8 (VCC)
unnamed: D1.1 (K), R3.2
unnamed: D2.1 (K), RN10.8 (R1.2)
unnamed: D3.2 (A), D4.1 (K), R12.2
unnamed: D5.2 (A), R13.2
unnamed: D6.1 (K), U10.7 (GP0)
unnamed: F2.2, JP6.2
unnamed: JP2.1, U9.21 (RCLR)
unnamed: JP6.1, P10.20
unnamed: P2.1, U7.55 (~STB)
unnamed: P2.2, U7.53 (PD0)
unnamed: P2.3, U7.52 (PD1)
unnamed: P2.4, U7.51 (PD2)
unnamed: P2.5, U7.50 (PD3)
unnamed: P2.6, U7.49 (PD4)
unnamed: P2.7, U7.48 (PD5)
unnamed: P2.8, U7.47 (PD6)
unnamed: P2.9, U7.46 (PD7)
unnamed: P2.10, U7.68 (~ACK)
unnamed: P2.11, U7.66 (BUSY)
unnamed: P2.12, U7.67 (PE)
unnamed: P2.13, U7.65 (SLCT)
unnamed: P2.14, U7.56 (~AFD)
unnamed: P2.15, U7.63 (~ERR)
unnamed: P2.16, U7.57 (~INIT)
unnamed: P2.17, U7.58 (~SLIN)
unnamed: P2.26 (S1), U21.2 (RA1)
unnamed: P2.27 (S2), U21.4 (RA3)
unnamed: P2.28 (S3), U21.6 (DY2)
unnamed: P2.29 (S4), U21.8 (DY3)
unnamed: P2.31 (S6), U21.3 (RA2)
unnamed: P2.32 (S7), U21.5 (DY1)
unnamed: P2.33 (S8), U21.7 (RA4)
unnamed: P2.34 (S9), U21.9 (RA5)
unnamed: P3.2, SP1.2
unnamed: P3.4, R2.1, R6.1, SP1.1
unnamed: P5.6, U8.28 (DRATE0)
unnamed: P8.1, R15.1
unnamed: P8.2, R14.1
unnamed: P9.7 (1), U11.9 (PD5)
unnamed: P9.11 (5), U11.11 (PD6)
unnamed: Q1.1 (B), R7.2
unnamed: Q2.1 (B), RN10.4 (R4.1)
unnamed: R1.1, R2.2
unnamed: R4.1, U20.13 (B5)
unnamed: R5.2, U20.14 (B4)
unnamed: R7.1, U22.4
unnamed: R8.2, RN10.5 (R4.2), U27.3 (Q)
unnamed: R6.2, R20.1
unnamed: U9.2 (X1), Y1.1
unnamed: U9.3 (X2), Y1.4
unnamed: U12.5 (E2), U14.8, U17.5 (E2)
unnamed: U12.7 (O7), U28.12
unnamed: U13.3, U14.5
unnamed: U13.6, U24.10
unnamed: U14.6, U33.6 (E3)
unnamed: U14.9, U18.8
unnamed: U14.11, U33.14 (O1)
unnamed: U14.13, U33.9 (O6)
unnamed: U17.6 (E3), U18.6
unnamed: U7.30 (~RI0), U21.12 (RY5)
unnamed: U7.25 (~DTR0), U21.13 (DA3)
unnamed: U7.28 (~CTS0), U21.14 (RY4)
unnamed: U7.26 (SOUT0), U21.15 (DA2)
unnamed: U7.24 (~RTS0), U21.16 (DA1)
unnamed: U7.41 (SIN0), U21.17 (RY3)
unnamed: U7.31 (~DSR0), U21.18 (RY2)
unnamed: U7.29 (~DCD0), U21.19 (RY1)
unnamed: U9.14 (AS), U22.8
unnamed: U22.9, U23.13 (O2)
unnamed: U9.15 (~R/W), U23.12 (O3)
unnamed: U24.3, U24.5
unnamed: U24.6, U24.9
unnamed: U24.8, U29.1 (A->B)
unnamed: U24.11, U34.11
unnamed: U28.3, U28.4
unnamed: U34.2, U34.3
unnamed: U34.4, U34.5
unnamed: U34.6, U34.9
unnamed: U34.10, U34.13
OSC: U3.20 (OSC), U20.7 (A5)
OSCDRV: ISA1.30 (OSC), ISA2.30 (OSC), ISA3.30 (OSC), ISA4.30 (OSC), P6.59, R4.2
PS2Mouse_RX: U7.10 (SOUT1), U11.2 (PD0)
PS2Mouse_TX: U7.62 (SIN1), U11.3 (PD1)
PWR_SW1: C8.1, P8.8, R8.1, SW6.1
PWR_SW2: P8.6, RN10.6 (R3.2), RN10.7 (R2.2), SW6.2, U27.2 (TR), U27.6 (THR)
QS0: U1.25 (QS0), U2.25 (QS0)
QS1: U1.24 (QS1), U2.24 (QS1)
RDATA: P5.30, R18.2, U8.41 (RDDATA)
READY: U1.22 (READY), U2.22 (READY), U3.17 (READY)
RESET: U1.21 (RESET), U2.21 (RESET), U3.18 (RESET), U26.9 (A7)
ROM_A16: RN3.1 (R1.1), SW1.12, U6.2 (A16)
RS232_GND: NT1.1, P2.30 (S5), P2.S0 (Shield)
RSTDRV: ISA1.2 (RESET), ISA2.2 (RESET), ISA3.2 (RESET), ISA4.2 (RESET), P6.3, U8.32 (RESET), U22.5, U26.11 (B7)
STEP: P5.20, U8.55 (STEP)
TC: ISA1.27 (TC), ISA2.27 (TC), ISA3.27 (TC), ISA4.27 (TC), P6.53, U8.25 (TC), U20.17 (B1)
TRK00: P5.26, R16.2, U8.2 (TRK0)
UART_CLK: U7.4 (CLK), X1.5 (OUT)
UART_IRQ: SW3.1, SW3.2, U7.45 (INT0)
UMBSW1: RN11.3 (R3.1), SW2.12, U31.1
UMBSW2: RN11.2 (R2.1), SW2.11, U31.2
UMBSW3: RN11.4 (R4.1), SW2.10, U31.13
UMBSW4: RN12.4 (R4.1), SW2.9, U31.3
UMBSW5: RN12.3 (R3.1), SW2.8, U31.4
UMBSW6: RN12.2 (R2.1), SW2.7, U31.5
VCC: C1.1, C12.2, C13.2, C14.2, C15.1, C16.1, C17.1, C18.1, C19.1, C20.2, C21.2, C22.1, C23.2, C24.2, C25.2, C26.2, C27.2, C28.1, C29.1, C30.2, C31.2, C32.1, C33.1, C34.1, C35.1, C36.2, C37.2, C38.1, C39.2, C40.2, C41.2, C42.1, C43.1, C44.1, C45.1, C46.1, C47.1, C48.1, C49.1, C50.1, C51.1, C60.2, C61.2, C62.2, C63.2, C64.1, C65.2, C66.2, C67.2, C68.2, C69.2, C70.2, F1.1, F2.1, ISA1.3 (VCC), ISA1.29 (VCC), ISA2.3 (VCC), ISA2.29 (VCC), ISA3.3 (VCC), ISA3.29 (VCC), ISA4.3 (VCC), ISA4.29 (VCC), P1.36 (~WE), P1.44 (~REG), P3.1, P6.5, P6.57, P7.4 (5V), P7.6 (5V), P7.19 (5V), P7.20 (5V), P10.29, R9.1, R13.1, R14.2, R16.1, R17.1, R18.1, R19.1, RN1.5 (R4.2), RN1.6 (R3.2), RN1.7 (R2.2), RN1.8 (R1.2), RN2.5 (R4.2), RN2.6 (R3.2), RN2.7 (R2.2), RN2.8 (R1.2), RN3.5 (R4.2), RN3.6 (R3.2), RN3.7 (R2.2), RN4.5 (R4.2), RN4.6 (R3.2), RN4.7 (R2.2), RN4.8 (R1.2), RN5.5 (R4.2), RN5.6 (R3.2), RN5.7 (R2.2), RN5.8 (R1.2), RN6.5 (R4.2), RN6.6 (R3.2), RN6.7 (R2.2), RN6.8 (R1.2), RN7.5 (R4.2), RN7.6 (R3.2), RN7.7 (R2.2), RN7.8 (R1.2), RN8.5 (R4.2), RN8.6 (R3.2), RN8.7 (R2.2), RN8.8 (R1.2), RN11.5 (R4.2), RN11.6 (R3.2), RN11.7 (R2.2), RN11.8 (R1.2), RN12.5 (R4.2), RN12.6 (R3.2), RN12.7 (R2.2), RN12.8 (R1.2), RN13.5 (R4.2), RN13.6 (R3.2), RN13.7 (R2.2), RN13.8 (R1.2), SW1.5, U2.34 (~BHE~/S7), U4.32 (VCC), U5.32 (VCC), U6.32 (VCC), U7.1 (PEMD), U7.23 (VCC), U7.40 (VCC), U7.64 (VCC), U8.27 (IDENT), U8.39 (PLL0), U8.46 (AVCC), U9.18 (~RESET), U9.24 (VCC), U10.1 (VDD), U11.20 (VCC), U12.16 (VCC), U13.14 (VCC), U14.14 (VCC), U15.20 (VCC), U16.20 (VCC), U17.16 (VCC), U18.14 (VCC), U19.20 (VCC), U20.1 (A->B), U20.20 (VCC), U21.20 (VCC), U22.14 (VCC), U23.6 (E3), U23.16 (VCC), U24.13, U24.14 (VCC), U25.20 (VCC), U26.1 (A->B), U26.20 (VCC), U28.14 (VCC), U29.20 (VCC), U31.14 (VCC), U32.16 (VCC), U33.16 (VCC), U34.14 (VCC), U35.20 (VCC), U36.1 (A->B), U36.20 (VCC), U37.20 (VCC), X1.8 (Vcc)
Vsync: P2.48 (V14), P4.14
WDATA: P5.22, U8.53 (WRDATA)
WE: P5.24, U8.52 (WE)
WP: P5.28, R17.2, U8.1 (WP)
XAEN: U3.30 (AEN), U26.8 (A6)
XALE: U3.69 (BALE), U20.2 (A0)
blu: P2.37 (V3), P4.6
bluGND: P2.42 (V8), P4.5
grn: P2.36 (V2), P4.8
grnGND: P2.41 (V7), P4.7
red: P2.35 (V1), P4.10
redGND: P2.40 (V6), P4.9
vgaGND: P2.39 (V5), P2.44 (V10), P2.V0 (Shield), P4.11
vgaID0: P2.45 (V11), P4.3
vgaID1: P2.46 (V12), P4.13
vgaID2: P2.38 (V4), P4.1
vgaID3: P2.49 (V15), P4.4
vgaPWR: P2.43 (V9), P4.2
~1F0: JP3.1 (A), U12.12 (O3)
~2E8: SW3.7, SW4.6, U17.13 (O2)
~2F0: JP5.1 (A), U12.10 (O5)
~2F8: SW3.9, SW4.4, U17.12 (O3)
~3E8: SW3.8, SW4.5, U17.9 (O6)
~3F0: SW1.6, U28.11
~3F8: SW3.10, SW4.3, U17.7 (O7)
~16C552_Read: U22.10, U24.1
~70: U12.15 (O0), U23.5 (E2)
~170: JP1.1 (A), U12.13 (O2)
~270: JP4.1 (A), U12.11 (O4)
~278: SW5.5, U17.14 (O1)
~378: SW5.6, U17.10 (O5)
~80000-9FFFF: U28.6, U31.9
~A0: U13.9, U14.2
~A19: U22.2, U28.5, U32.5 (E2)
~BA7: D3.1 (K), D4.2 (A), U22.12
~BCS1: P1.7 (~CS0), P10.37, U36.11 (B7)
~BCS3: P1.32 (~CS1), P10.38, U36.12 (B6)
~BIOR_Delay: P1.34 (~IORD), P10.25, U36.13 (B5)
~BIOW: P1.35 (~IOWR), P10.23, U36.14 (B4)
~BRESET: P1.41 (~RESET), P10.1, U36.15 (B3)
~C0000-C7FFF: SW2.1, U32.15 (O0)
~C8000-CFFFF: SW2.2, U32.14 (O1)
~CF_Master: P1.39 (~CSEL), RN3.4 (R4.1), SW1.9
~D0000-D7FFF: SW2.3, U32.13 (O2)
~D8000-DFFFF: SW2.4, U32.12 (O3)
~DACK0: ISA1.19 (~DACK0), ISA2.19 (~DACK0), ISA3.19 (~DACK0), ISA4.19 (~DACK0), P6.37, U20.15 (B3)
~DACK1: ISA1.17 (~DACK1), ISA2.17 (~DACK1), ISA3.17 (~DACK1), ISA4.17 (~DACK1), P6.33, U26.18 (B0)
~DACK2: ISA1.26 (~DACK2), ISA2.26 (~DACK2), ISA3.26 (~DACK2), ISA4.26 (~DACK2), P6.51, U8.3 (~DACK), U20.16 (B2)
~DACK3: ISA1.15 (~DACK3), ISA2.15 (~DACK3), ISA3.15 (~DACK3), ISA4.15 (~DACK3), P6.29, U26.17 (B1)
~DASP: P1.45 (~DASP), P10.39, RN2.1 (R1.1), U14.3
~DEN: U3.71 (~DEN), U16.19 (CE)
~E0000-E7FFF: SW2.5, U32.11 (O4)
~E0_PASS: RN8.3 (R3.1), SW1.14, U10.4 (GP3)
~E8000-EFFFF: SW2.6, U32.10 (O5)
~EN_RAM: RN8.4 (R4.1), SW1.13, U13.5
~F0000-F7FFF: U18.1, U32.9 (O6)
~F8000-FFFFF: U18.2, U32.7 (O7)
~FDC_CS: RN3.2 (R2.1), SW1.11, U8.6 (CS)
~IDE_Addr: JP1.2 (B), JP3.2 (B), JP4.2 (B), JP5.2 (B), SW1.7
~IDE_CS: RN3.3 (R3.1), SW1.10, U13.10, U13.12, U28.9, U33.5 (E2)
~IDE_CS1: U13.11, U36.9 (A7)
~IDE_CS3: U13.8, U36.8 (A6)
~IDE_PDIAG: P1.46 (~PDIAG), P10.34
~IDE_Read: U24.4, U28.8
~IOCHK: ISA1.32 (IO), ISA2.32 (IO), ISA3.32 (IO), ISA4.32 (IO), P6.2, U3.27 (~IOCHK)
~IOR: ISA1.14 (~IOR), ISA2.14 (~IOR), ISA3.14 (~IOR), ISA4.14 (~IOR), P6.27, RN5.4 (R4.1), U7.37 (~IOR), U8.4 (~RD), U23.2 (A1), U26.16 (B2), U28.10, U33.2 (A1), U34.1
~IOR_Delay: U34.8, U36.7 (A5)
~IOW: ISA1.13 (~IOW), ISA2.13 (~IOW), ISA3.13 (~IOW), ISA4.13 (~IOW), P6.25, RN5.3 (R3.1), U7.36 (~IOW), U8.5 (~WR), U23.3 (A2), U26.15 (B3), U33.1 (A0), U36.6 (A4)
~LA1-OE: U33.10 (O5), U37.1 (OE)
~LA2-OE: U34.12, U35.1 (OE)
~LPT_CS: RN2.4 (R4.1), SW5.3, SW5.4, U7.38 (~CS2)
~MEMR: ISA1.12 (~SMEMR), ISA2.12 (~SMEMR), ISA3.12 (~SMEMR), ISA4.12 (~SMEMR), P6.23, RN5.2 (R2.1), U4.24 (OE#), U5.24 (OE#), U6.24 (OE), U13.4, U26.14 (B4)
~MEMW: ISA1.11 (~SMEMW), ISA2.11 (~SMEMW), ISA3.11 (~SMEMW), ISA4.11 (~SMEMW), P6.21, RN5.1 (R1.1), U4.29 (WE#), U5.29 (WE#), U6.31 (PGM), U26.13 (B5)
~MouseCfg1: JP8.2, U11.15 (PB3)
~MouseCfg2: JP8.4, U11.16 (PB4)
~Mouse_Activity: D5.1 (K), U11.13 (PB1)
~Mouse_CS: RN2.2 (R2.1), SW4.7, SW4.8, SW4.9, SW4.10, U7.3 (~CS1)
~PS2Mouse_RTS: U7.12 (~RTS1), U11.7 (PD3)
~PS_ON: P7.14 (~PS_ON), Q2.3 (C)
~RAMCS2: U5.22 (CE#), U18.13, U31.8
~RAM_CS: SW1.4, U18.11
~RESET: U7.39 (~RESET), U11.1 (PA2/~RESET), U22.6, U36.5 (A3)
~RESIN: P8.7, R11.1, RN12.1 (R1.1), SW7.2
~ROMCS: U6.22 (CE), U18.3
~RQ/GT0: RN1.2 (R2.1), U1.31 (~RQ~/~GT0~), U3.24 (~RQ/GT)
~RQ/GT1: RN1.3 (R3.1), U1.30 (~RQ~/~GT1~), U2.31 (~RQ~/~GT0~)
~RQ/GT2: RN1.1 (R1.1), U2.33 (~RQ~/~GT1~)
~RTC_Read: U9.17 (DS), U23.10 (O5), U24.2
~S0: RN4.2 (R2.1), U1.26 (~S0), U2.26 (~S0), U3.75 (~S0)
~S1: RN4.1 (R1.1), U1.27 (~S1), U2.27 (~S1), U3.74 (~S1)
~S2: RN1.4 (R4.1), U1.28 (~S2), U2.28 (~S2), U3.73 (~S2)
~SPKR: U3.14 (SPEAKR), U22.3
~TEST: RN4.3 (R3.1), U1.23 (~TEST), U2.23 (BUSY)
~UART_CS: RN2.3 (R3.1), SW3.3, SW3.4, SW3.5, SW3.6, U7.32 (~CS0)
~UMB_C0000-D7FFF: U31.11, U31.12
~UMB_D8000-EFFFF: U31.6, U31.10
~VID0: RN8.1 (R1.1), SW1.16, U3.12 (VID0)
~VID1: RN8.2 (R2.1), SW1.15, U3.13 (VID1)
~XDACK0: U3.63 (~DACK0), U20.5 (A3)
~XDACK1: U3.62 (~DACK1), U26.2 (A0)
~XDACK2: U3.61 (~DACK2), U20.4 (A2)
~XDACK3: U3.60 (~DACK3), U26.3 (A1)
~XIOR: U3.65 (~IOR), U26.4 (A2)
~XIOW: U3.66 (~IOW), U26.5 (A3)
~XMEMR: U3.67 (~MEMR), U26.6 (A4)
~XMEMW: U3.68 (~MEMW), U26.7 (A5)
~xLA2-OE: U24.12, U33.13 (O2)

Notes on the sheet:
-5V Regulator
ATX Power Connector
Mounting Holes
ATX Power On Circuit
ISA Slots
CPU Section
CF Slot
Remove pin 10 from header, and it is defacto-standard ASUS type
Speaker driver
SW1: System Config Default: 1, 2, 4, 6, 7, 8 ON Video card type: 1 ON, 2 ON : VGA/EGA/None 1 ON, 2 OFF : 80x25 CGA 1 OFF, 2 ON : 40x25 CGA 1 OFF, 2 OFF: MDA/Hercules 3: Enable E0 scancode passthrough for keyboard 4: Enable onboard RAM (remove RAM if disabling) 5: Use 2nd half of system ROM instead 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
RTC
Serial and Parallel
C9 only needed for Intel FDC
Front Panel Header
RAM and ROM
Keyboard and Mouse
Bus Interface
PC/104 Platform
Multi-unit Part Power
CPU Activity Indicator
XT-IDE
Remove pin 3 from header
It's feature-creepy!
Install C6 or C59
Floppy Disk Controller
SW2: UMB Config Default: All off 1: C0000-C7FFF 2: C8000-CFFFF 3: D0000-D7FFF 4: D8000-DFFFF 5: E0000-E7FFF 6: E8000-EFFFF
Decoupling Capacitors
LPT
UART
IDE
I/O Address Decoder
FDC
REV B changes: - tidied up some footprints for increased ease of building. - added pull-down resistor at 16C552_Read, to prevent undefined state if 16C552 is removed (causing board to not work).
