monotech/NuXTv2/(notices)

Notices in the files:
Project NuXT.sch:
Monotech PCs | License: GFDLv3
